Robyn-J-Pollock/Mini_DC_Motor_Driver_w_ToF_Detection/Distance_Sensor.kicad_sch

## KiCad design Distance_Sensor.kicad_sch (2026-10-13)

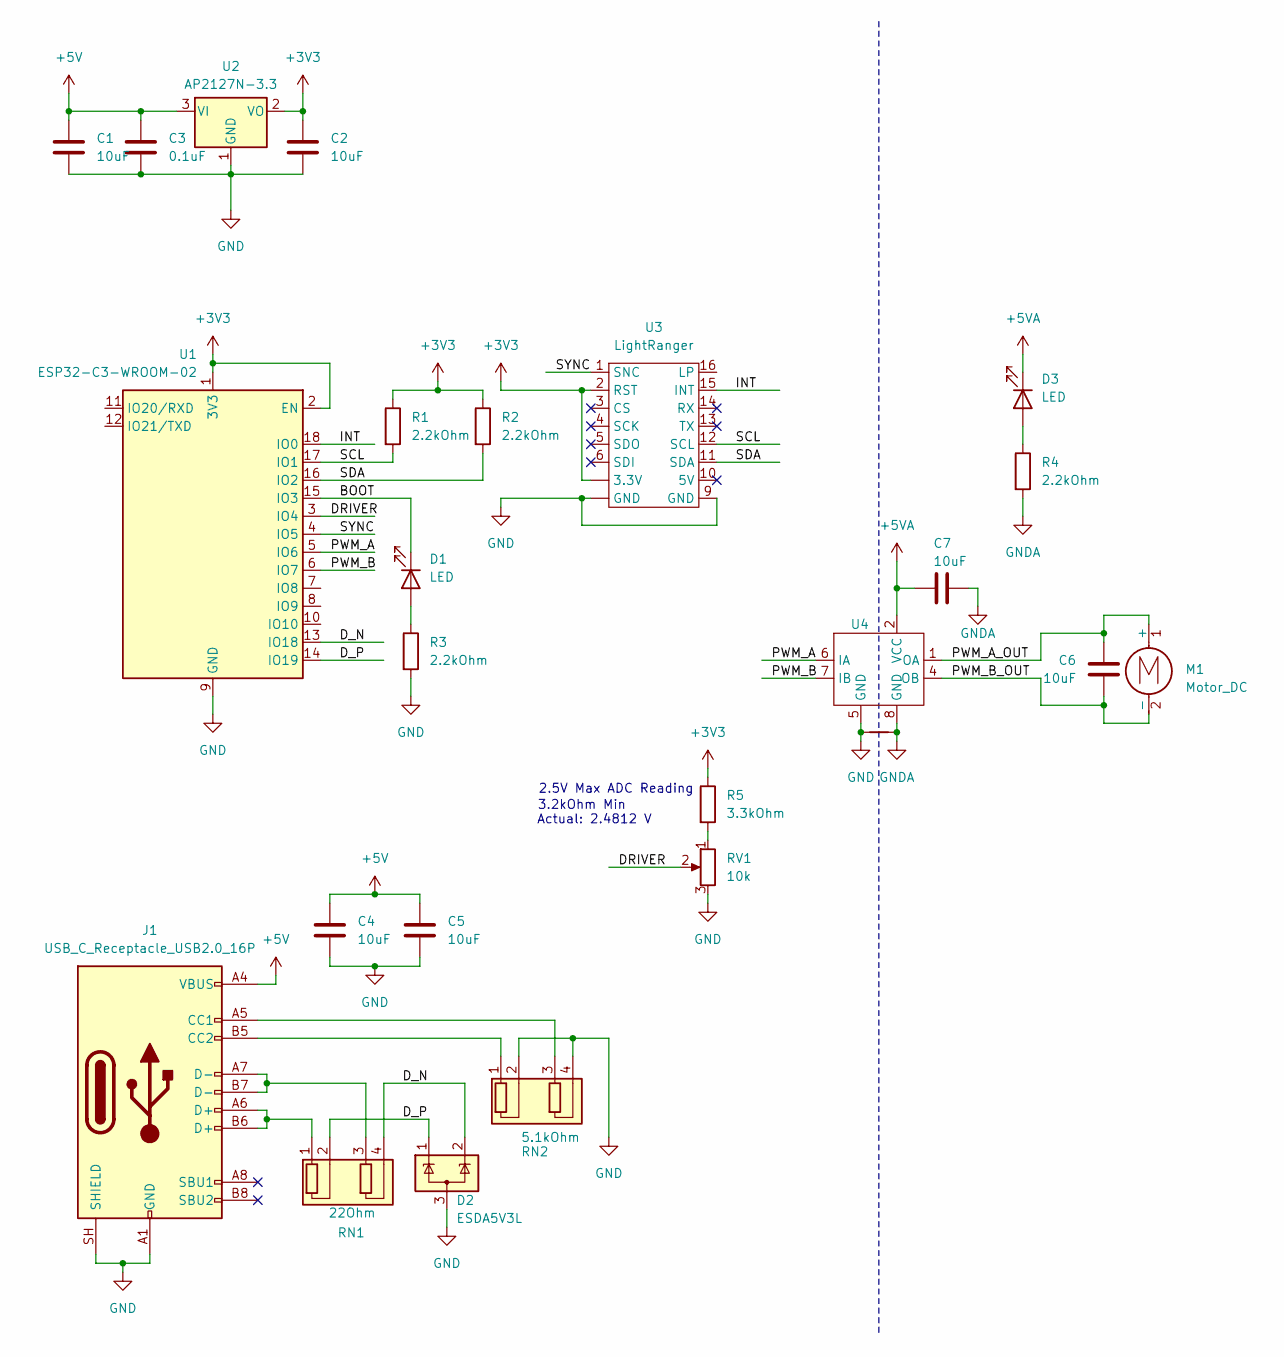
[picture p1: schematic Distance_Sensor.kicad_sch]

Parts:
C1: 10uF; SOIC-8_3.9x4.9mm_P1.27mm
C2, C4, C5, C6, C7: 10uF
C3: 0.1uF; SOIC-8_3.9x4.9mm_P1.27mm
D1, D3: LED
D2: ESDA5V3L; SOT-23-3
J1: USB_C_Receptacle_USB2.0_16P; UQFN-16_1.8x2.6mm_P0.4mm
M1: Motor_DC
NT1: NetTie_2
R1, R2, R3, R4: 2.2kOhm
R5: 3.3kOhm
RN1: 22Ohm; R_Array_SIP4
RN2: 5.1kOhm; R_Array_SIP4
RV1: 10k; TSSOP-20_4.4x6.5mm_P0.65mm
U1: ESP32-C3-WROOM-02
U2: AP2127N-3.3; SOT-23
U3: LightRanger; R_LDR_D6.4mm_P3.4mm_Vertical
U4: (no value)

Connections:
+3V3: C2.1, R1.1, R2.1, R5.1, U1.1 (3V3), U1.2 (EN), U2.2 (VO), U3. (3.3V), U3.2 (RST)
+5V: C1.1, C3.1, C4.1, C5.1, J1.A4 (VBUS), J1.A9 (VBUS), J1.B4 (VBUS), J1.B9 (VBUS), U2.3 (VI)
+5VA: C7.1, D3.1 (K), U4.2 (VCC), U4.3 (VCC)
BOOT: D1.1 (K), U1.15 (IO3)
DRIVER: RV1.2, U1.3 (IO4)
D_N: D2.2 (K), RN1.4 (R2.2), U1.13 (IO18)
D_P: D2.1 (K), RN1.2 (R1.2), U1.14 (IO19)
GND: C1.2, C2.2, C3.2, C4.2, C5.2, D2.3 (A), J1.A1 (GND), J1.A12 (GND), J1.B1 (GND), J1.B12 (GND), J1.SH (SHIELD), NT1.1, R3.2, RN2.2 (R1.2), RN2.4 (R2.2), RV1.3, U1.9 (GND), U1.19 (GND), U2.1 (GND), U3. (3.3V), U3.9 (GND), U4.5 (GND)
GNDA: C7.2, NT1.2, R4.2, U4.8 (GND)
INT: U1.18 (IO0), U3.15 (INT)
unnamed: D1.2 (A), R3.1
unnamed: D3.2 (A), R4.1
unnamed: J1.A5 (CC1), RN2.3 (R2.1)
unnamed: J1.A6 (D+), J1.B6 (D+), RN1.1 (R1.1)
unnamed: J1.A7 (D-), J1.B7 (D-), RN1.3 (R2.1)
unnamed: J1.B5 (CC2), RN2.1 (R1.1)
unnamed: R5.2, RV1.1
PWM_A: U1.5 (IO6), U4.6 (IA)
PWM_A_OUT: C6.1, M1.1 (+), U4.1 (OA)
PWM_B: U1.6 (IO7), U4.7 (IB)
PWM_B_OUT: C6.2, M1.2 (-), U4.4 (OB)
SCL: R1.2, U1.17 (IO1), U3.12 (SCL)
SDA: R2.2, U1.16 (IO2), U3.11 (SDA)
SYNC: U1.4 (IO5), U3.1 (SNC)

Notes on the sheet:
3.2kOhm Min
2.5V Max ADC Reading
Actual: 2.4812 V
