Robyn-J-Pollock/Mini_DC_Motor_Driver_w_ToF_Detection/QT/Distance_Map/main.cpp

#include <QGuiApplication>
#include <QQmlApplicationEngine>

int main(int argc, char *argv[])
{
    QGuiApplication app(argc, argv);

    QQmlApplicationEngine engine;
    QObject::connect(
        &engine,
        &QQmlApplicationEngine::objectCreationFailed,
        &app,
        []() { QCoreApplication::exit(-1); },
        Qt::QueuedConnection);
    engine.loadFromModule("Distance_Map", "Main");

    return QCoreApplication::exec();
}
